About-Time-Technologies/Stage-Landing-Lights/hardware/pcb/Landing-Light/Landing-Light.step

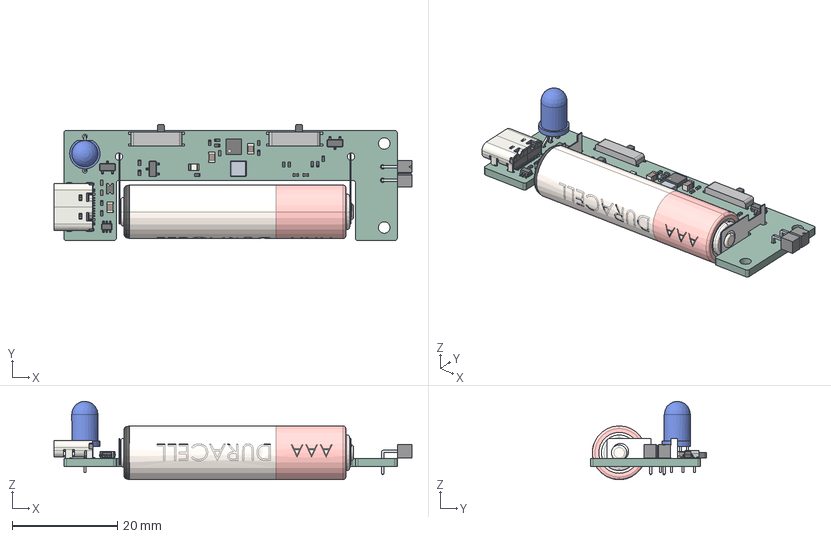
[picture p1: CAD file, 2026-01-10]
hardware/pcb/Landing-Light/Landing-Light.step
68.2 x 22.2 x 14.9 mm
R_0402_1005Metric x 15
LeadsArray
C_0805_2012Metric x 3
C_0402_1005Metric x 5
Texas_S-PVSON-N10
SOT-363_SC-70-6
SOT-23
Switch x 2
USB_C_Receptacle_GCT_USB4105-xx-A_16P_TopMnt_Horizontal
LED_D5.0mm-4_RGB_Wide_Pins
AAA Battery
D_0805_2012Metric
Landing-Light 1.28.1
SOT-23-3 x 2
LED_0805_2012Metric
Landing-Light_PCB
