About-Time-Technologies/Stage-Landing-Lights/hardware/pcb/Landing-Light/mill-max-399-10-104-10-008000.STEP

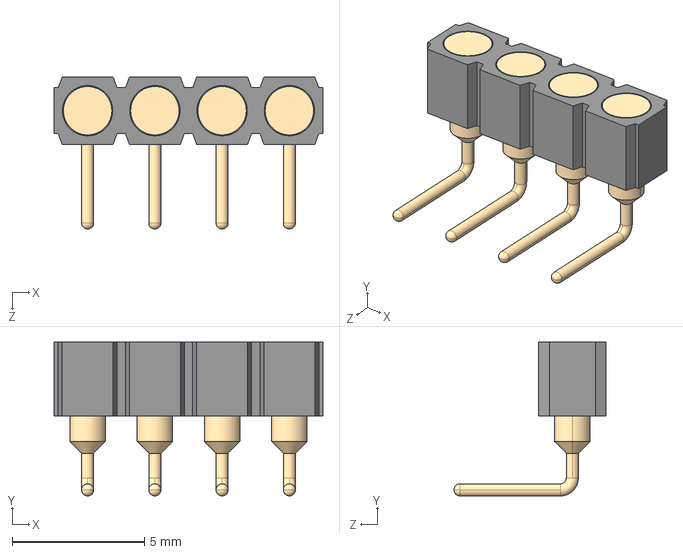
[picture p2: CAD file, 2025-04-16]
hardware/pcb/Landing-Light/mill-max-399-10-104-10-008000.STEP
10.2 x 5.81 x 5.74 mm
P3XX-11-010-00-000000_P304-11-010-00-000000
1940BENT_default x 4
