About-Time-Technologies/Stage-Landing-Lights/hardware/pcb/Landing-Light/Switch.step

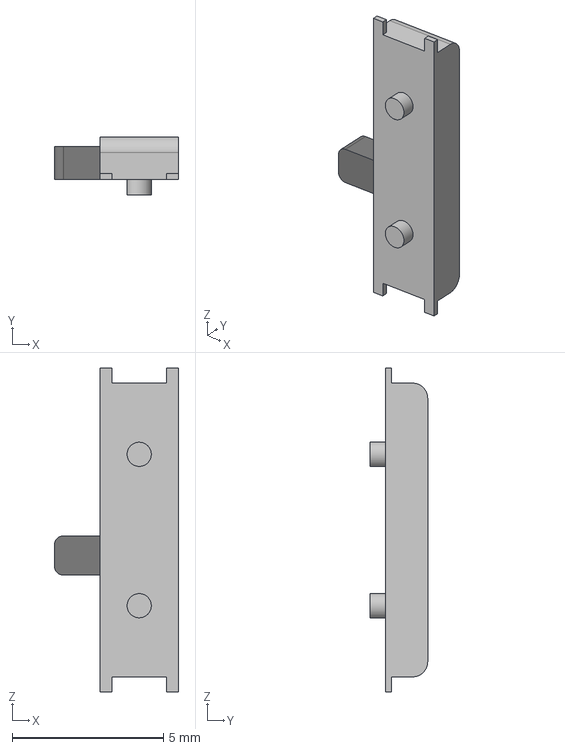
[picture p3: CAD file, 2024-12-16]
hardware/pcb/Landing-Light/Switch.step
4.10 x 1.90 x 10.7 mm
