About-Time-Technologies/Stage-Landing-Lights/hardware/pcb/Landing-Light/70AAJ-6-F1.STEP

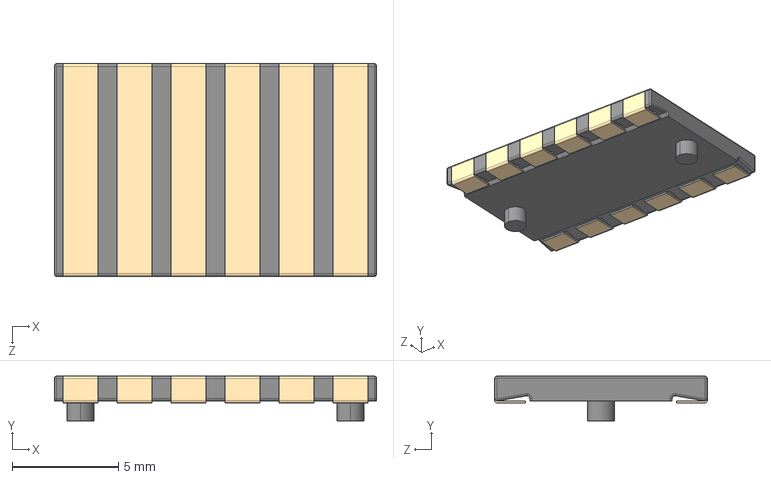
[picture p4: CAD file, 2024-12-09]
hardware/pcb/Landing-Light/70AAJ-6-F1.STEP
15.1 x 2.11 x 10.0 mm
