About-Time-Technologies/Stage-Landing-Lights/hardware/pcb/Landing-Light/230-1.step

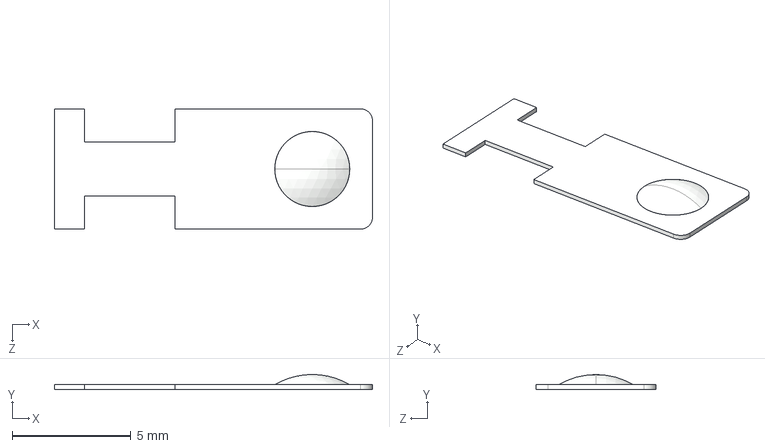
[picture p5: CAD file, 2024-12-08]
hardware/pcb/Landing-Light/230-1.step
13.4 x 0.635 x 5.08 mm
