About-Time-Technologies/Stage-Landing-Lights/hardware/pcb/Landing-Light/AAA Battery.STEP

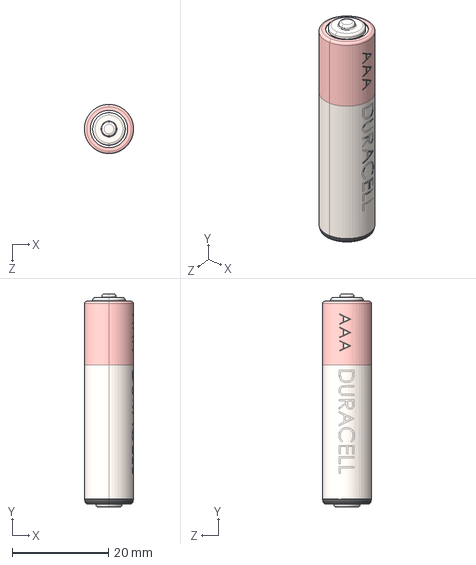
[picture p6: CAD file, 2024-12-08]
hardware/pcb/Landing-Light/AAA Battery.STEP
10.2 x 44.4 x 10.2 mm
