About-Time-Technologies/Stage-Landing-Lights/hardware/pcb/Landing-Light/BQ25172DSGR.STEP

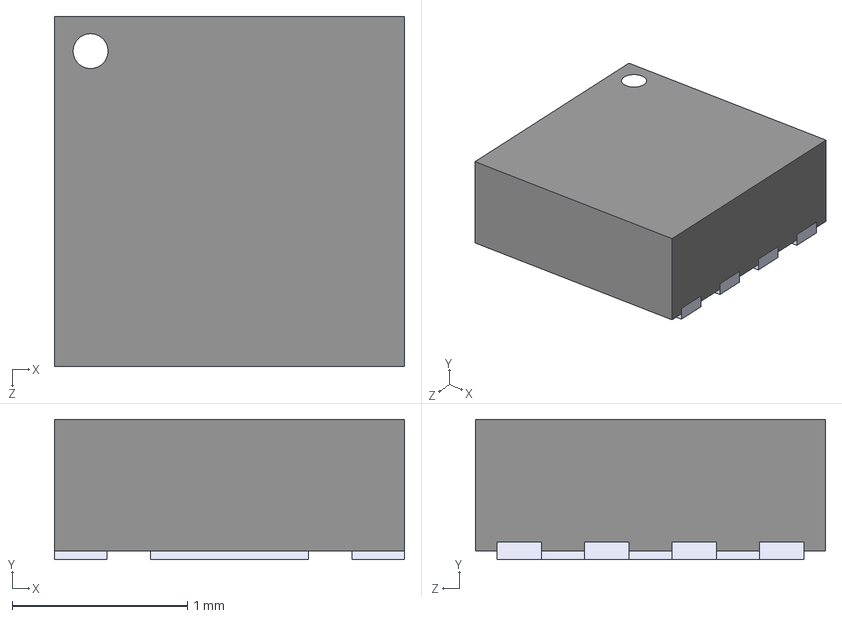
[picture p7: CAD file, 2024-12-09]
hardware/pcb/Landing-Light/BQ25172DSGR.STEP
2.00 x 0.8 x 2.00 mm
