About-Time-Technologies/Stage-Landing-Lights/hardware/pcb/Landing-Light/2012670005.step

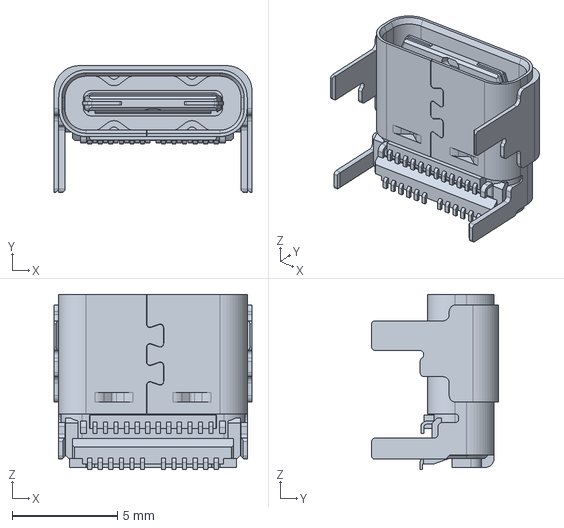
[picture p8: CAD file, 2024-12-09]
hardware/pcb/Landing-Light/2012670005.step
9.39 x 6.01 x 8.30 mm
