About-Time-Technologies/Stage-Landing-Lights/hardware/pcb/Landing-Light/Landing-Light.kicad_pcb

## KiCad design hardware/pcb/Landing-Light/Landing-Light.kicad_pcb (2026-10-17)

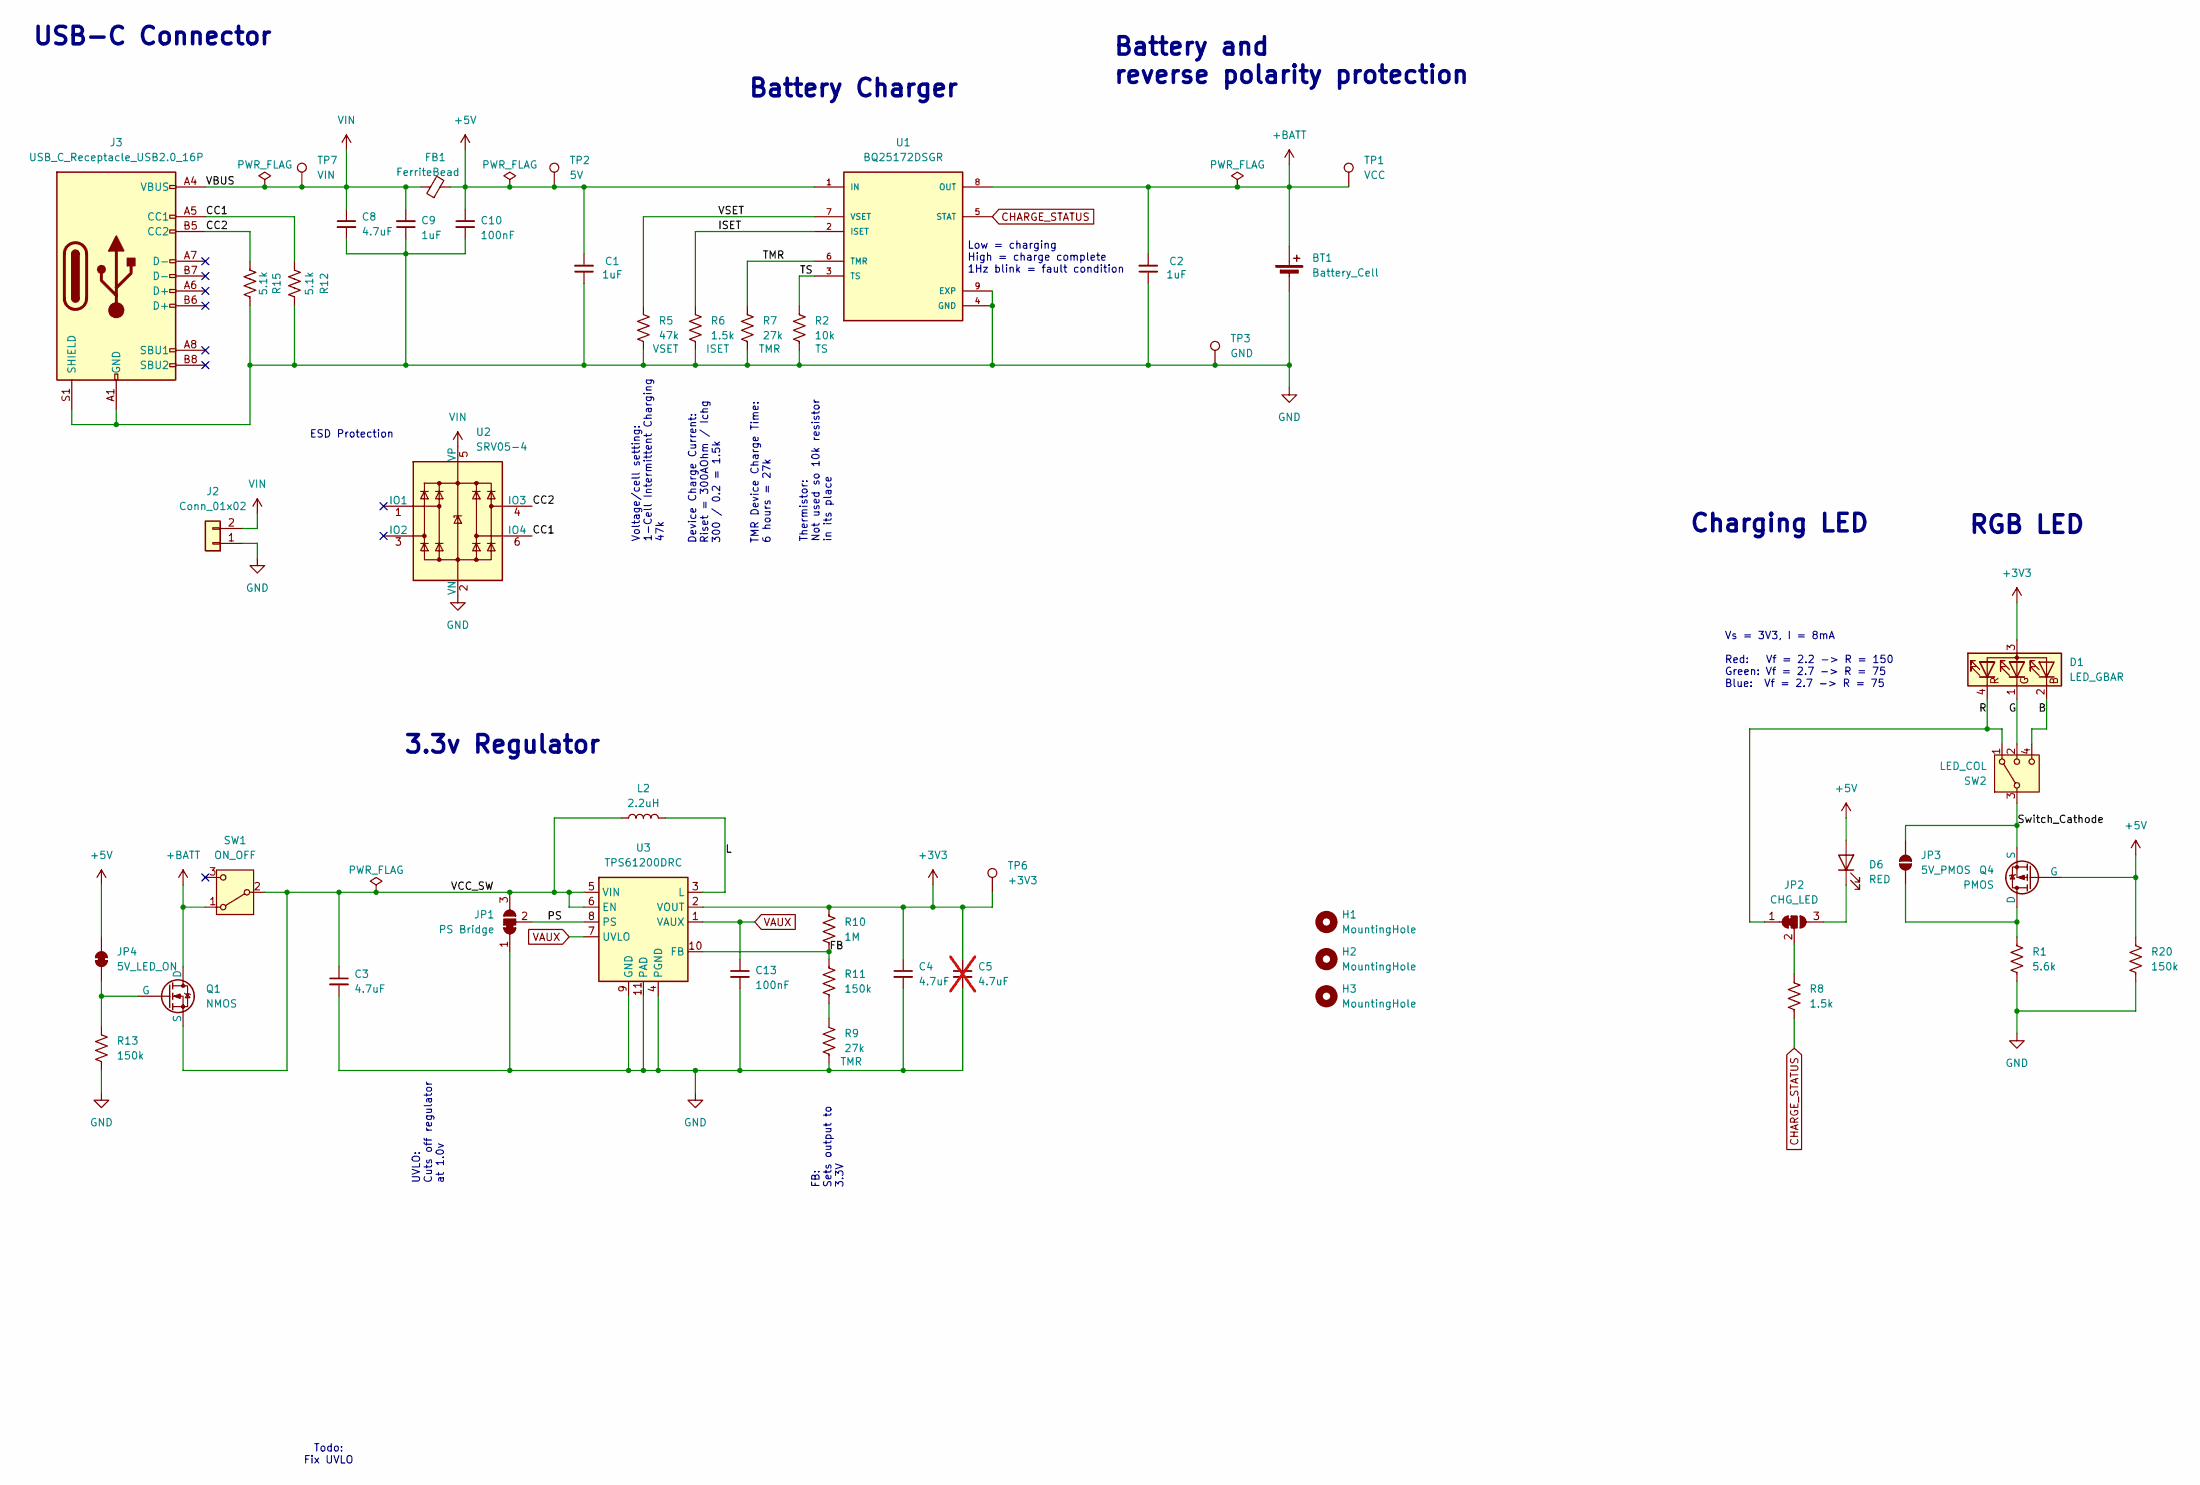
[picture p9: schematic Landing-Light.kicad_sch]

Parts:
BT1: Battery_Cell; AAA Side Mount
C1, C2, C9: 1uF; C_0402_1005Metric; LCSC C52923
C3, C4, C8: 4.7uF; C_0805_2012Metric; LCSC C1779
C5: 4.7uF; C_0805_2012Metric; LCSC C1779; not fitted
C10, C13: 100nF; C_0402_1005Metric; LCSC C1525
D1: LED_GBAR; LED_D5.0mm-4_RGB_Wide_Pins
D6: RED; LED_0805_2012Metric; LCSC C84256
FB1: FerriteBead; D_0805_2012Metric; LCSC C1015
H1, H2, H3: MountingHole; MountingHole_2.2mm_M2
J2: Conn_01x02; HDRRA2W46P0X254_1X2_508X279X254P
J3: USB_C_Receptacle_USB2.0_16P; USB_C_Receptacle_G-Switch_GT-USB-7010ASV; LCSC C2894897
JP1: PS Bridge; SolderJumper-3_P1.3mm_Bridged2Bar12_RoundedPad1.0x1.5mm
JP2: CHG_LED; SolderJumper-3_P1.3mm_Bridged2Bar12_RoundedPad1.0x1.5mm
JP3: 5V_PMOS; SolderJumper-2_P1.3mm_Open_RoundedPad0.5x0.75mm
JP4: 5V_LED_ON; SolderJumper-2_P1.3mm_Bridged_RoundedPad0.5x0.75mm
L2: 2.2uH; L_Sunlord_SWPA3015S; LCSC C19734
Q1: NMOS; SOT-23-3-JLCPCB; LCSC C20917
Q4: PMOS; SOT-23; LCSC C10487
R1: 5.6k; R_0402_1005Metric; LCSC C25908
R2: 10k; R_0402_1005Metric; LCSC C25744
R5: 47k; R_0402_1005Metric; LCSC C25792
R6, R8: 1.5k; R_0402_1005Metric; LCSC C25867
R7, R9: 27k; R_0402_1005Metric; LCSC C25771
R10: 1M; R_0402_1005Metric; LCSC C26083
R11, R13, R20: 150k; R_0402_1005Metric; LCSC C25755
R12, R15: 5.1k; R_0402_1005Metric; LCSC C25905
SW1: ON_OFF; SSSS810201; LCSC C231762
SW2: LED_COL; SSSS812201; LCSC C160878
TP1: VCC; TestPoint_Pad_D1.0mm
TP2: 5V; TestPoint_Pad_D1.0mm
TP3: GND; TestPoint_Pad_D1.0mm
TP6: +3V3; TestPoint_Pad_D1.0mm
TP7: VIN; TestPoint_Pad_D1.0mm
U1: BQ25172DSGR; IC_BQ25172DSGR; PARTREV June 2022; LCSC C5189434
U2: SRV05-4; SOT-363_SC-70-6; LCSC C15879
U3: TPS61200DRC; Texas_S-PVSON-N10_ThermalVias; LCSC C140320

Connections:
+3V3: C4.1, C5.1, D1.3 (A), R10.1, TP6.1 (1_1), U3.2 (VOUT)
+5V: C1.2, C10.1, D6.2 (A), FB1.2, JP4.1 (A), Q4.1 (G), R20.1, TP2.1 (1_1), U1.1 (IN)
+BATT: BT1.1 (+), C2.2, Q1.1 (D), SW1.1 (A), TP1.1 (1_1), U1.8 (OUT)
/B: D1.2 (BK), SW2.4
/CC1: J3.A5 (CC1), R12.1, U2.6 (IO4)
/CC2: J3.B5 (CC2), R15.1, U2.4 (IO3)
/FB: R10.2, R11.1, U3.10 (FB)
/G: D1.1 (GK), SW2.2
/ISET: R6.1, U1.2 (ISET)
/L: L2.2, U3.3 (L)
/PS: JP1.2 (C), U3.8 (PS)
/R: D1.4 (RK), JP2.1 (A), SW2.1
/Switch_Cathode: JP3.2 (B), Q4.2 (S), SW2.3
/TMR: R7.1, U1.6 (TMR)
/TS: R2.1, U1.3 (TS)
/VCC_SW: C3.1, JP1.3 (B), L2.1, Q1.3 (S), SW1.2 (B), U3.5 (VIN), U3.6 (EN)
/VSET: R5.1, U1.7 (VSET)
CHARGE_STATUS: R8.2, U1.5 (STAT)
GND: BT1.2 (-), C1.1, C2.1, C3.2, C4.2, C5.2, C8.2, C9.1, C10.2, C13.2, J2.1, J3.A1 (GND), J3.A12 (GND), J3.B1 (GND), J3.B12 (GND), J3.S1 (SHIELD), JP1.1 (A), R1.2, R2.2, R5.2, R6.2, R7.2, R9.2, R12.2, R13.2, R15.2, R20.2, TP3.1 (1_1), U1.4 (GND), U1.9 (EXP), U2.2 (VN), U3.4 (PGND), U3.9 (GND), U3.11 (PAD)
unnamed: D6.1 (K), JP2.3 (B)
unnamed: JP2.2 (C), R8.1
unnamed: JP3.1 (A), Q4.3 (D), R1.1
unnamed: JP4.2 (B), Q1.2 (G), R13.1
unnamed: R9.1, R11.2
VAUX: C13.1, U3.1 (VAUX), U3.7 (UVLO)
VIN: C8.1, C9.2, FB1.1, J2.2, J3.A4 (VBUS), J3.A9 (VBUS), J3.B4 (VBUS), J3.B9 (VBUS), TP7.1 (1_1), U2.5 (VP)

Notes on the sheet:
UVLO: Cuts off regulator at 1.0v
Battery and reverse polarity protection
Vs = 3V3, I = 8mA Red: Vf = 2.2 -> R = 150 Green: Vf = 2.7 -> R = 75 Blue: Vf = 2.7 -> R = 75
RGB LED
TMR Device Charge Time: 6 hours = 27k
3.3v Regulator
Battery Charger
Charging LED
Voltage/cell setting: 1-Cell Intermittent Charging 47k
Todo: Fix UVLO
FB: Sets output to 3.3V
Thermistor: Not used so 10k resistor in its place
Device Charge Current: Riset = 300AOhm / Ichg 300 / 0.2 = 1.5k
ESD Protection
Low = charging High = charge complete 1Hz blink = fault condition
USB-C Connector

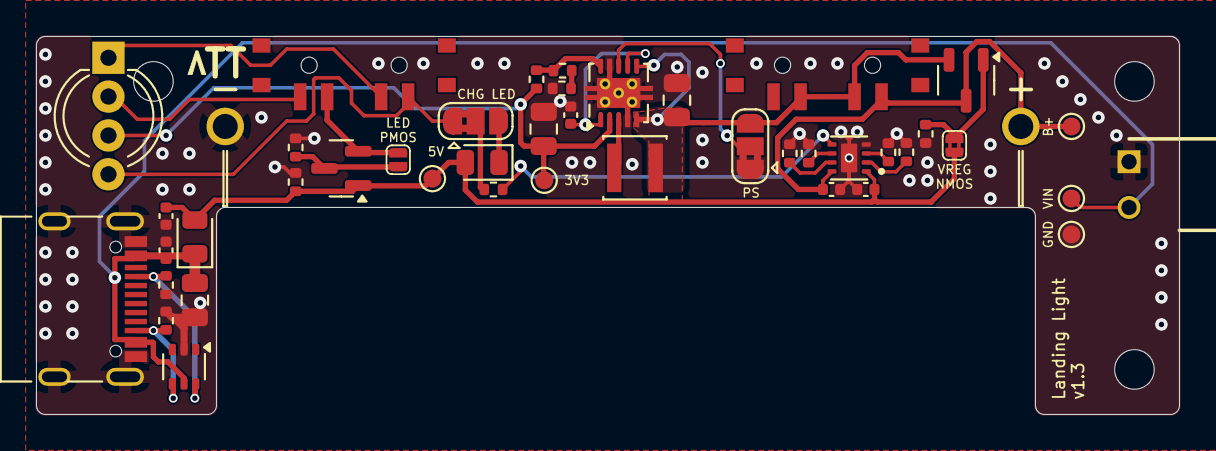
[picture p10: board Landing-Light.kicad_pcb from above]

Board: 2 copper layers, 63.5 x 21.0 mm, 47 parts (0 on the bottom side), 26 nets.
