About-Time-Technologies/Stage-Landing-Lights/(threads)

Thread 1 (2025-05-09):

Reverse battery protection stops device from charging when off

minorDeveloper, 2025-05-09:
The reverse battery protection circuit uses a voltage from the boost board to determine correct polarity and connect BAT- to GND. This however stops the battery from charging when the device is off, as the boost IC is not powered, GND is not connected, and the battery IC GND is not connected to BAT-.

Thread 2 (2025-05-09):

LED is too bright for landing light applications

minorDeveloper, 2025-05-09:
As stated, the resistor value of 500R is too small for landing light applications. It is suitable for illumination tasks, but not for the landing light.

A value of 4K7 + 500R was found to be suitable for this application. Consider a 5K variable resistor to continue providing flexibility.
