About-Time-Technologies/Stage-Landing-Lights/(commit log)

2024-12-08 Basic components added
    [230-1.step, AAA Battery.STEP, Landing-Light.kicad_pcb, Landing-Light.kicad_sch]
2024-12-09 Footprints complete
    [2012670005.step, Landing-Light.kicad_pcb, Landing-Light.kicad_sch]
2024-12-09 Removing old regulator
    [Landing-Light.kicad_sch]
2024-12-09 TVS Diode LCSC Number
    [Landing-Light.kicad_sch]
2024-12-09 Changing to new layout
    [Landing-Light.kicad_pcb, Landing-Light.kicad_sch]
2024-12-09 Reinstating USB-C
    [Landing-Light.kicad_sch]
2024-12-09 Tidying up layout
    [70AAJ-6-F1.STEP, BQ25172DSGR.STEP, Landing-Light.kicad_pcb, Landing-Light.kicad_sch, Landing-Light.step]
2024-12-16 Routing complete
    [Landing-Light.kicad_pcb, Landing-Light.kicad_sch, Switch.step]
2024-12-16 Layout labelling
    [Landing-Light.kicad_sch]
2024-12-16 Tidy resistor values
    [Landing-Light.kicad_pcb, Landing-Light.kicad_sch]
2024-12-18 Final layout checks
    [Landing-Light.kicad_pcb, Landing-Light.kicad_sch]
2024-12-18 Rotating silkscreen
    [Landing-Light.kicad_pcb]
2024-12-18 v1 Production
    [Landing-Light.kicad_pcb, Landing-Light.kicad_sch]
2024-12-18 Fix via sizes
    [Landing-Light.kicad_pcb]
2024-12-18 Final footprint fixes
    [Landing-Light.kicad_pcb, Landing-Light.kicad_sch]
2024-12-27 Comments added after first production run
    [Landing-Light.kicad_sch]
2025-04-11 Adding new pogo connector
    [Landing-Light.kicad_pcb, Landing-Light.kicad_sch, Landing-Light.step]
2025-04-13 Update power routing
    [Landing-Light.kicad_pcb, Landing-Light.kicad_sch]
2025-04-14 Complete redesign - starting point
    [Landing-Light.kicad_pcb, Landing-Light.kicad_sch]
2025-04-15 Tidying via placement
    [Landing-Light.kicad_pcb, Landing-Light.kicad_sch]
2025-04-15 Clean ground plane
    [Landing-Light.kicad_pcb, Landing-Light.kicad_sch]
2025-04-16 Finalise BOM
    [Landing-Light.kicad_pcb, Landing-Light.kicad_sch, mill-max-399-10-104-10-008000.STEP]
2025-04-16 v1.1 production
    [Landing-Light.kicad_pcb, Landing-Light.kicad_sch]
2025-11-14 Change charger connection point
    [Landing-Light.kicad_sch]
2025-12-23 v1.2 notes and structure
    [Landing-Light.kicad_pcb, Landing-Light.kicad_sch]
2025-12-29 Restructuring power flow for clarity
    [Landing-Light.kicad_sch]
2026-01-03 v1.2 Production
    [Landing-Light.kicad_pcb, Landing-Light.kicad_sch]
2026-01-03 Custom solder jumpers
2026-01-03 Initial files for charging board
    [Landing-Light-Charging.kicad_pcb, Landing-Light-Charging.kicad_sch]
2026-01-10 Adding notes for small fixes to v1.3
    [Landing-Light.kicad_sch, Landing-Light.step]
